mayaanmalik2486/robot-car/Docs/qr/README.md

# QR codes

Scan with a phone camera. Print them, stick them on the car, put them on a poster.

| QR code | Opens |
| :---: | --- |
|  | **Download the app** (RobotCar.apk, Android) |
|  | **This GitHub repository** |
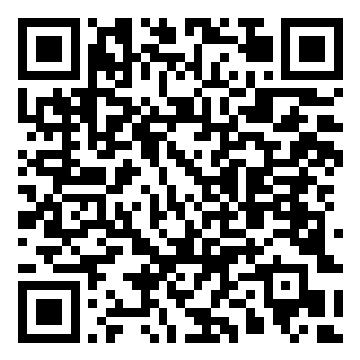
[picture p5: Docs/qr/qr-app-guide.png]
|  | **The app guide** (install, connect, buttons, controller) |
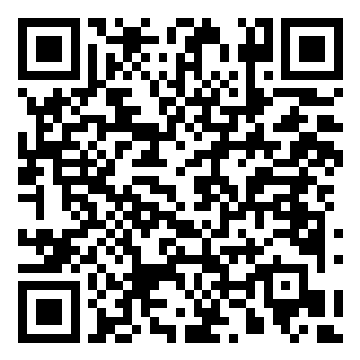
[picture p6: Docs/qr/qr-car-cv.png]
|  | **The car's CV** (every detail) |
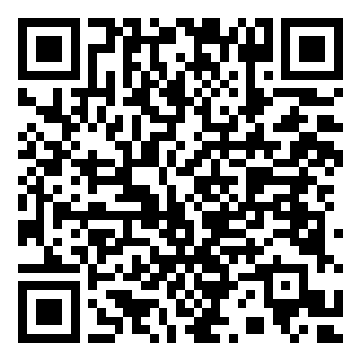
[picture p7: Docs/qr/qr-full-guide.png]
|  | **The full guide** (everything the car and app can do) |
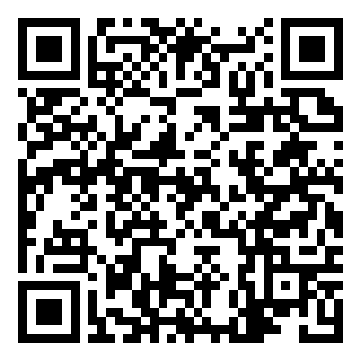
[picture p8: Docs/qr/qr-song-list.png]
|  | **The 39 songs** and how to dance in time |

Every code was checked by scanning it back.
