mayaanmalik2486/robot-car/Old_Versions/README.md

# Old versions

Every earlier version of the robot car code, oldest first. Nothing here is needed to use the car:
the newest program is in [`Robot_Car_Main`](../Robot_Car_Main), the newest dances are in [`Dances`](../Dances),
and the dances from before the choreography are in [`Dances_Before_Choreography`](../Dances_Before_Choreography).

| Folder | What it was |
|---|---|
| `00_Starter_Tutorial_Code` | The obstacle-avoiding car tutorial the project started from (by Science N Music Studio, for a different motor board) |
| `01_Servo_Only_Test` | Moves only the servo, to test it safely |
| `02_Guardian_V1_Obstacle_Avoider` | First obstacle avoider for this car |
| `03_Obstacle_Avoiding_4WD` | Another early obstacle avoider |
| `04_V0_Best_Code` | "best code": the first version on this wiring |
| `05_V1_Turn_And_Move_Ahead` | v1: turns and moves ahead a bit |
| `06_V2_Turn_On_Its_Axis` | v2: turns on the spot |
| `07_V3_Obstacle_Detection` | v3: obstacle detection |
| `08_V4_Better_Obstacle_Detection` | v4: better obstacle detection |
| `09_V5_Cliff_Sensor_Prototype_Not_Working` | v5 prototype with a cliff (falling-off) sensor - did not work |
| `10_V5_Whole_Remote` | v5: the whole IR remote |
| `11_V5_5_Better_Remote` | v5.5: better remote |
| `12_V5_5_Bluetooth_Test` | v5.5 with the first Bluetooth test |
| `13_V6_Semi_Bluetooth` | v6: part Bluetooth |
| `14_V7_Asura_Final` | v7 "Asura" |
| `15_V7_In_The_Making` | v7 in the making |
| `16_V7_1_Robot_Original` | v7.1: the version the big upgrade started from |
| `17_V8_First_GitHub_Upload` | v8: eyes, search, chaos, dance (first upload to GitHub) |
| `18_V9_Before_Choreography` | v9: the main program just before the choreography (drum/tune dances, "drift" still called drift) |
