mayaanmalik2486/robot-car/App/Old_APKs/README.md

# Old app versions

Every version of the Robot Car app, oldest first. The newest one is always `../RobotCar.apk` (now 4.2, November 11 2026: the HEAD page - a wheel that turns the sensor head).

| File | Version | What it was |
|---|---|---|
| RobotCar_v1.0.apk | 1.0 (Oct 19, 2026) | First app: portrait, a button for every mode, live status |
| RobotCar_v2.0.apk | 2.0 (Oct 19, 2026) | Game-pad layout, landscape, emoji buttons, game controller support |
| RobotCar_v3.0.apk | 3.0 (Oct 20, 2026) | Tilt driving, Moves / Play / Radar pages, radar map, song name, pressable buttons, racing controller map |
| RobotCar_v3.1.apk | 3.1 (Oct 20, 2026) | Spots an old car program, speed button fix, link log, safer screen tap |
| RobotCar_v4.1.apk | 4.1 (Nov 11, 2026) | The new look: a live 3D car, a steering wheel and a throttle lever, glossy bubble buttons, animations |
| RobotCar_v4.0.apk | 4.0 (Nov 10, 2026) | Smooth steering, the GameSir Cyclone 2 map (all changeable), settings, controller screen, two sticks |

To install an older one, download it on the phone and install it. Android only lets you install an
OLDER version after uninstalling the newer one first.
