mayaanmalik2486/robot-car/Docs/screens/phone-head.png

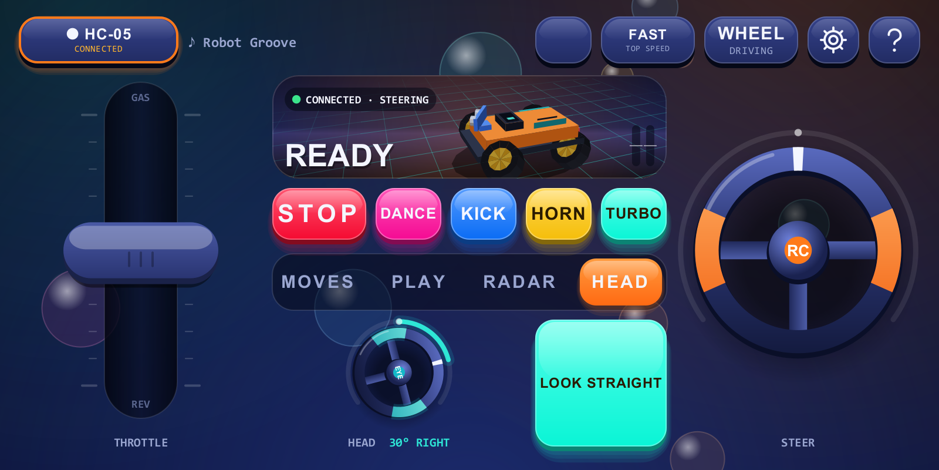
Docs/screens/phone-head.png
