mayaanmalik2486/robot-car/Docs/screens/phone-one-stick-dance.png

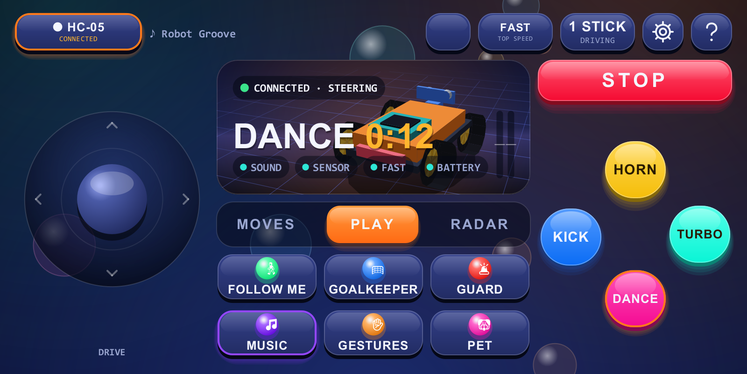
Docs/screens/phone-one-stick-dance.png
