mayaanmalik2486/robot-car/Docs/screens/tablet-wheel-radar.png

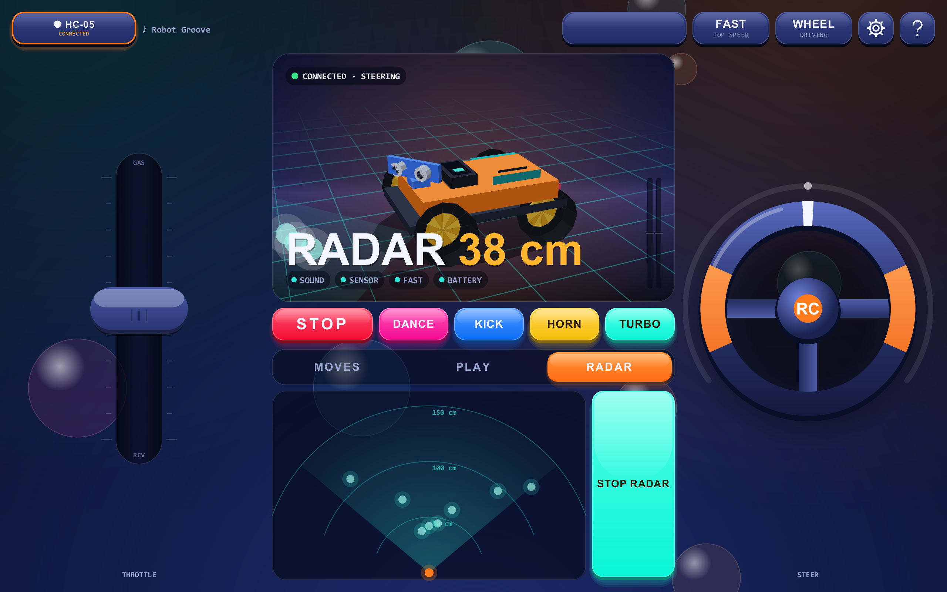
Docs/screens/tablet-wheel-radar.png
