mayaanmalik2486/robot-car/(commit log)

2026-10-18 Tidy up: main program, 38 song dances, old versions, tools
    - Robot_Car_Main: the latest robot program (v9) + wiring guide
    - Dances: one program per song (38), named Song_Artist, with a README
    - Old_Versions: every earlier version, oldest first
    - Tools: the scripts that made and tested the dances in a simulator
    - README with controls, wiring and how to upload
2026-10-18 Add Badtameez Dil dance (Pritam, 106 BPM, D minor)
    Choruses and the brass dance break are POWER parts. Simulator: 627/627
    moves on the beat (worst 6 ms), 706/706 tune notes right, stops at 4:13.
2026-10-19 Real choreography for every song
    Each song now has its own dance steps (signature moves) and a routine for
    every part of the song that repeats each time that part comes back, with
    phrase-end poses, lead-ins before big parts and a finale.
    Engine: per-song SONG_MOVES table, FREEZE pose move, SOFT (slow-motion)
    and ROUND (exactly one full turn, timed from TURN180_TIME) modifiers, and a
    BACK right after a DASH snaps back at full speed so hits don't creep.
    Tools: choreo.js (step dictionary + all routines), check-choreo.js (every
    step brings the car back to its spot), simulator checker updated.
    Simulator: 53 runs pass, 12624/12624 moves on the beat, 18288/18288 notes.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
    [Aal_Izz_Well_3_Idiots.ino, Aankhen_Milaney_Waaley_Nazia_Hassan.ino, Ambarsariya_Sona_Mohapatra.ino, Baba_Bandook_Ali_Azmat.ino, Badtameez_Dil_Pritam.ino, Ben_10_1_Classic_Theme.ino, Ben_10_2_Alien_Force_Theme.ino, Ben_10_3_Ultimate_Alien_Theme.ino]
2026-10-19 Curve (was drift): sharper turn; keep every old version in one place
    - Drift left/right is now CURVE left/right (forward while turning), on
    the screen too. The inner wheels run at 25 % instead of 60 % for a
    sharper turn (CURVE_INNER_PERCENT). Simulator test added.
    - The dance step "drift" is now "slow_step" (no clash with the drive mode).
    - Old_Versions now also has the starter tutorial, v8, v9 and all 39 song
    dances from before the choreography, with a README listing them in order.
    - All 40 current programs compile; main-program simulator tests all pass.
    [Aal_Izz_Well_3_Idiots.ino, Aankhen_Milaney_Waaley_Nazia_Hassan.ino, Ambarsariya_Sona_Mohapatra.ino, Baba_Bandook_Ali_Azmat.ino, Badtameez_Dil_Pritam.ino, Ben_10_1_Classic_Theme.ino, Ben_10_2_Alien_Force_Theme.ino, Ben_10_3_Ultimate_Alien_Theme.ino]
2026-10-19 Every sketch opens with Arduino Uno on COM4 (sketch.yaml)
2026-10-19 Football mode (V), sharper curve, old dances moved to the front
    - V / v toggles football mode: the distance sensor is ignored, so it never
    stops for obstacles (screen: FOOTBALL!). Press again for safety back on.
    - Curve: inner wheels now turn backward at 30 % (CURVE_INNER_PERCENT = -30)
    for a much sharper turn.
    - Dances_Before_Choreography moved from Old_Versions to the top level.
    - Simulator tests for both; all 40 programs compile.
2026-10-19 Football mode switches the distance sensor fully off (except search and chaos)
    V/v: no pings at all while driving by hand, dancing, auto modes (screen
    shows SENS OFF and FOOTBALL!). SEARCH and CHAOS still use the sensor.
    Simulator test counts the pings.
2026-10-19 Play modes, our own phone app, IR remote add-on, update-all-songs tool
    - Play modes (phone letters): follow me (M), goalkeeper (K) + kick (k),
    guard (A), music / hand theremin (N), gestures (E), pet (P), turbo (T),
    horn (Y, was demo). Low-battery self-check. Timed moves stop exactly.
    - The car tells the app what it is doing: "~MODE|flags" (muted, football,
    slow, low battery); '?' asks.
    - Room for it all: debug messages switched off (DEBUG_MESSAGES switch,
    saves 2.9 KB), IR remote moved into IR_Remote_Addon (one file + 3 lines,
    saves 2.1 KB), demo mode removed. Main 92.2 %, songs up to 94.7 %.
    - App/: native Android app (RobotCar.apk, 41 KB) - hold-to-drive arrows,
    every mode, liv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
2026-10-19 App v2: game-pad layout (landscape, thumbstick, emoji buttons) + game controller support
2026-10-19 Radar mode, song name to the app, app v3 (tilt, pages, radar, pressable buttons, racing controller map)
    - Car: radar mode (O) - sweeps the sensor, draws a radar map on the OLED, sends #R: dots
    - Car: answers '?' with the song name (#S:), in every song file
    - App 3.0: split into parts, Moves/Play/Radar pages, tilt driving, 3D buttons,
    GameSir Cyclone 2 / gamepad map like a racing game, controller rumble on alerts
    - Guides, IR add-on memory table, simulator radar test (394/394 checks pass)
2026-10-19 App 3.1: spots an old car program, speed button works without status, link log, screen tap no longer disconnects
    The play modes / radar / speed problems come from an older car program (no status line,
    no play modes): the app now says so and tells which program to upload. Added a simulator
    test that replays an app session against the car program.
2026-11-09 Servo full-speed test sketch
2026-11-10 App 4.0 + smooth steering: GameSir Cyclone 2 map, settings, controller screen, web remote
    Car (Robot_Car_Main + all 39 songs):
    - Steering: codes above 127 set each side's speed (-31..31), still stops for walls,
    stops by itself if the app goes quiet for 0.6 s; '?' also answers "#V:2"
    - Q/W work at once while reversing or spinning; smooth brake keeps a curve;
    every waiting letter is read each loop
    - New simulator tests: steering, speed-brake-fixes, app-replay
    App 4.0 (versionCode 5, same key):
    - DriveLogic: proportional steering, no flooding, parked sticks during modes, STOP
    - Cyclone 2 / any controller: all four modes, remappable map per controller, rumble
    - One stick / two sticks / tilt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
    [Aal_Izz_Well_3_Idiots.ino, Aankhen_Milaney_Waaley_Nazia_Hassan.ino, Ambarsariya_Sona_Mohapatra.ino, Baba_Bandook_Ali_Azmat.ino, Badtameez_Dil_Pritam.ino, Ben_10_1_Classic_Theme.ino, Ben_10_2_Alien_Force_Theme.ino, Ben_10_3_Ultimate_Alien_Theme.ino]
2026-11-11 App 4.1 + web: the new look - live 3D car, steering wheel + throttle lever, bubble keys
    - SceneView / scene.js: a small 3D engine of our own (the car from boxes and wheels, lit,
    sorted): wheels spin, the grid floor moves and turns, lean, dance bounce, radar sweep
    with dots on the floor, a red wall when blocked; it follows the controls when offline
    - WheelView: a real steering wheel (grab and turn, 126 degrees each way, springs back);
    StickView: a throttle lever (or one stick / tilt). "Wheel" is the new default
    - PadButton: glossy 3D bubble keys (hues, shine, glow, ripple, springy press, picture
    bubbles); sliding tab pill; night sky with drifting bubbles; entrance + page animations
    -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
2026-11-11 App 4.2 + web + car: HEAD - a wheel that turns the sensor head
    - Car: codes 6..26 point the servo (5 degrees a step, 50 each way); '?' answers "#V:3";
    +44 bytes; new simulator test "head"; all 39 songs regenerated (fullest 99.2 %)
    - App: a fourth page HEAD with a blue wheel (it stays where it is left), LOOK STRAIGHT,
    the 3D car's head turns too; controller: LB + right stick
    - Web: the same page and controller mapping
    - 4.1 archived in Old_APKs; guides updated
2026-11-12 Guide rewritten for app 4.2: what changed this week (before / now), steering, head, 3D app, controller, web, tests; PDF remade (+ the tool that makes it)
2026-11-12 CV updated to app 4.2: smooth steering, head codes, 3D app, web remote, new controller map, test record; PDFs remade
